ksergy1/wind-turbine-pressure-motors/manual/device_mgr.jpg

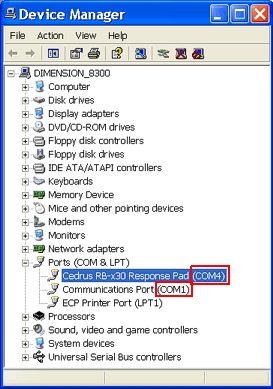
manual/device_mgr.jpg
