ksergy1/wind-turbine-pressure-motors/manual/manual3.jpg

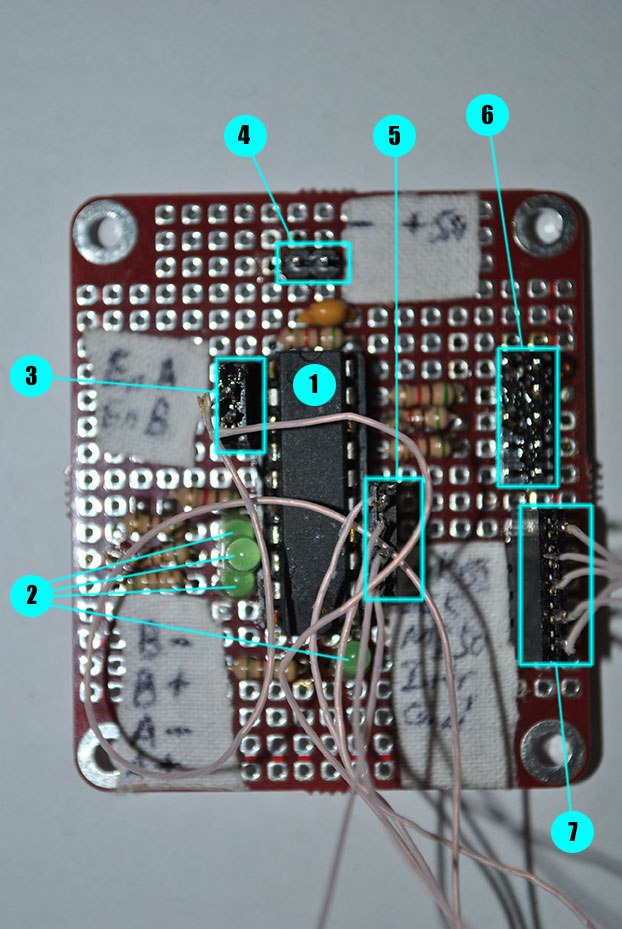
manual/manual3.jpg
