ksergy1/wind-turbine-pressure-motors/(list of files, cad)

Other CAD files:
asm/slave-drive-test/slave-drive-test.obj
asm/slave-spi-test/slave-spi-test.obj
asm/slave-uart/slave-uart.obj
asm/slave.backup/slave.backup.obj
asm/slave/slave.obj
asm/system-loopback-test/system-loopback-test.obj
asm/system-spi-test/system-spi-test.obj
asm/system-test-uart/system-test-uart.obj
asm/system/system.obj
