ksergy1/wind-turbine-pressure-motors/one-drv.pdf

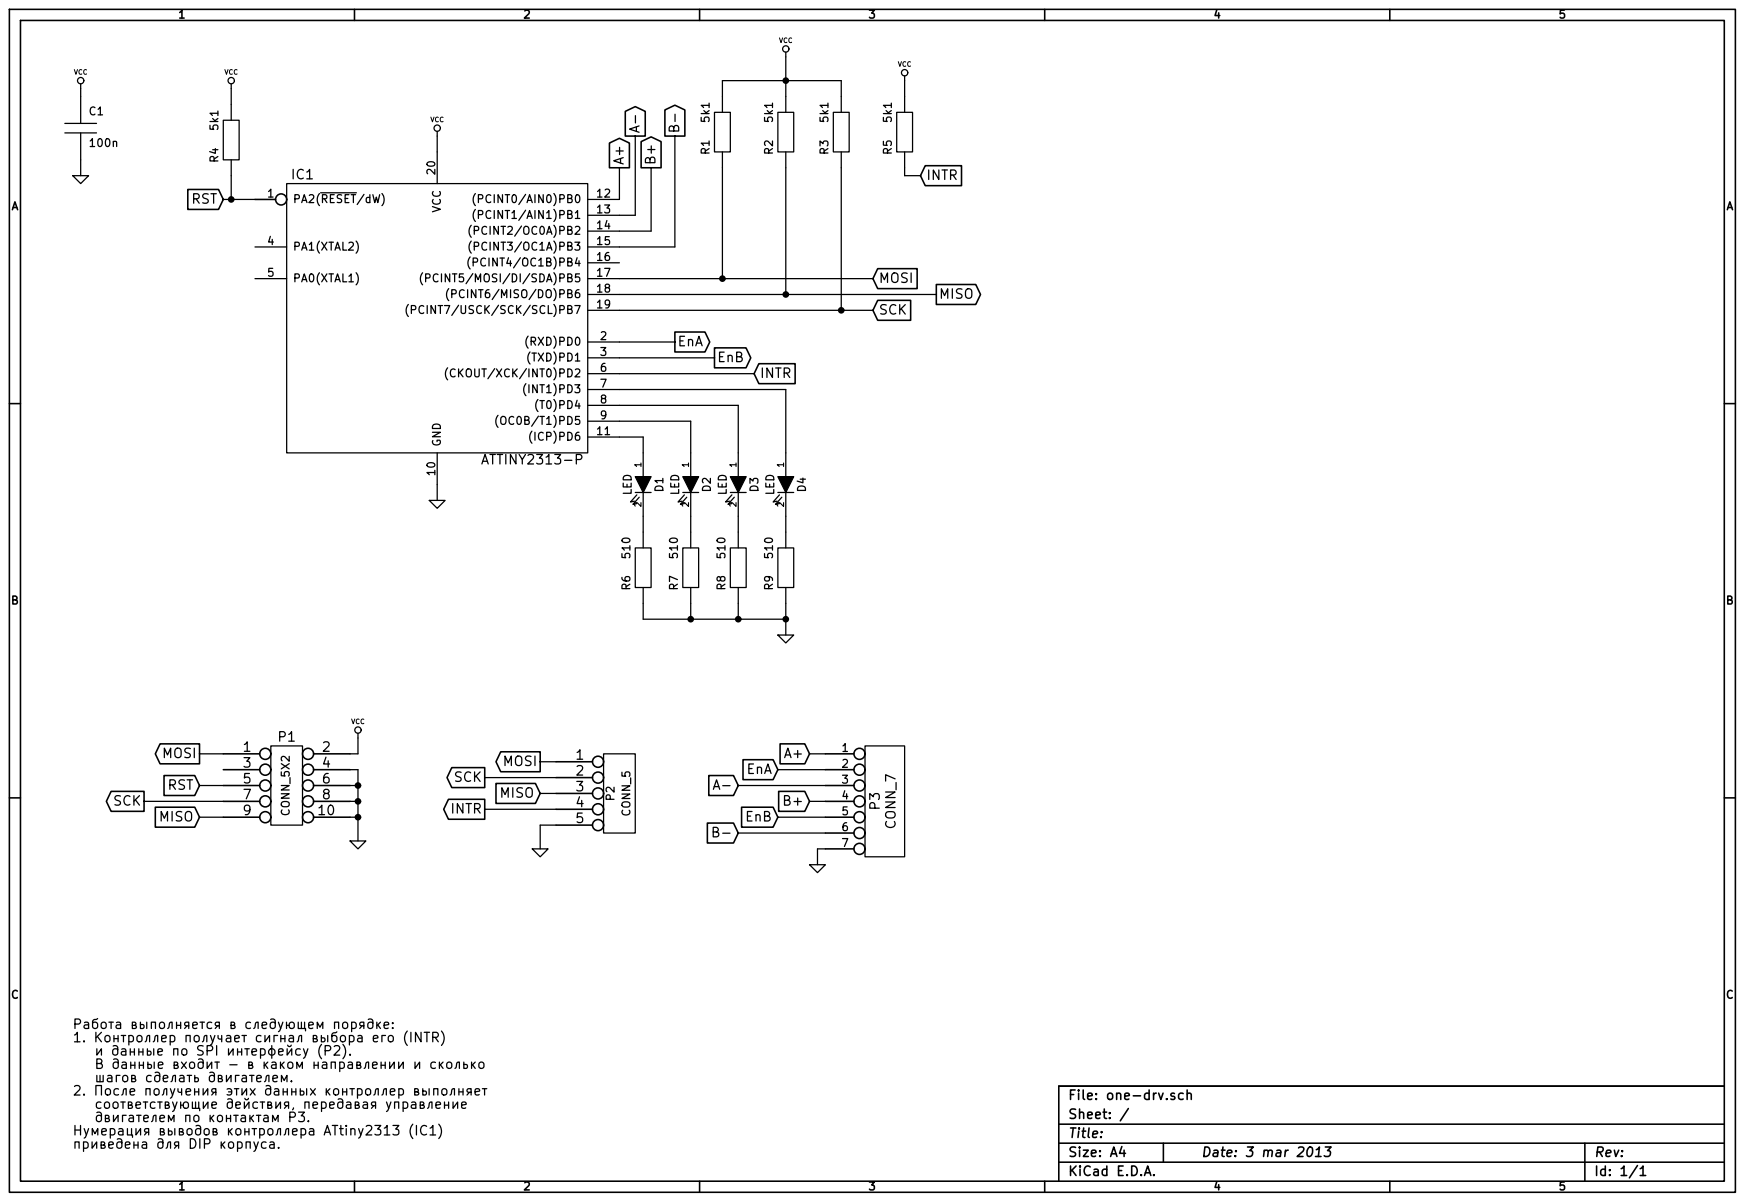
[picture p8: page 1]
