ksergy1/wind-turbine-pressure-motors/system.pdf

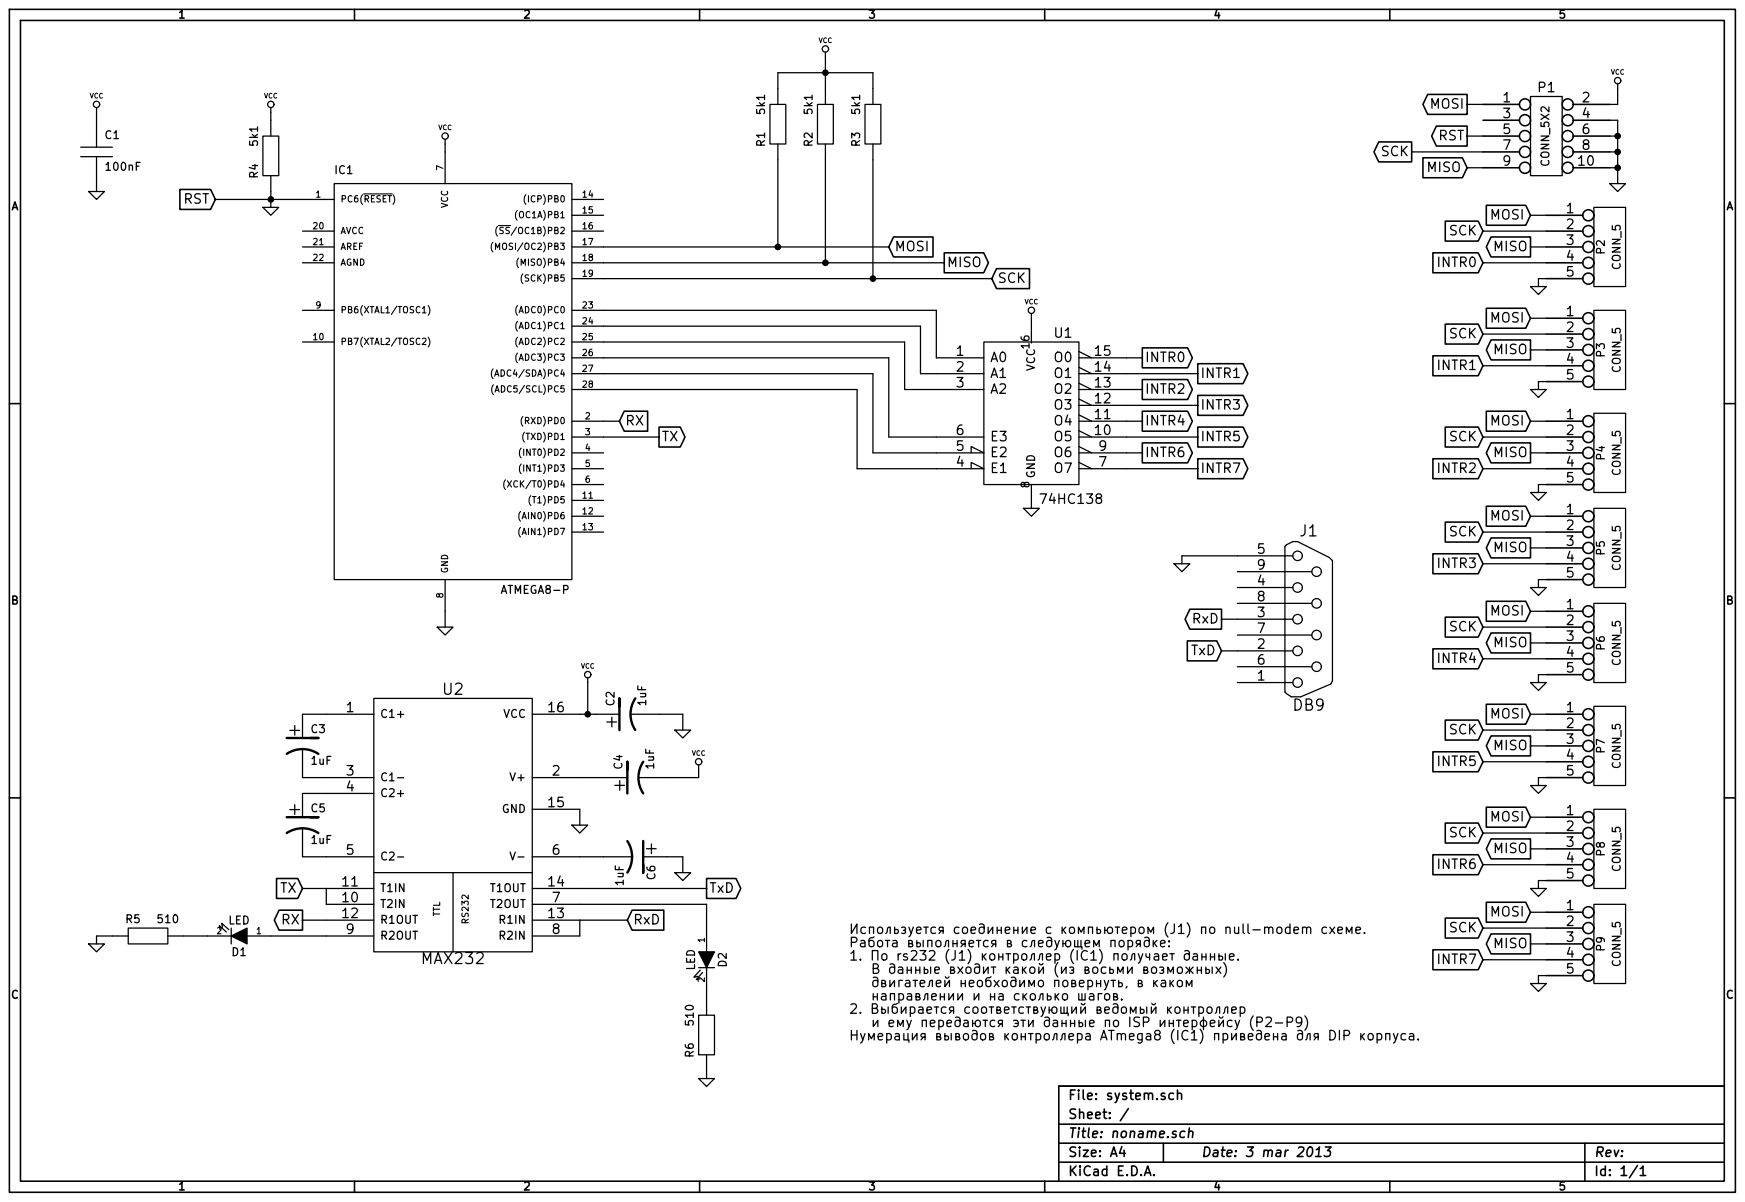
[picture p9: page 1]
