ksergy1/wind-turbine-pressure-motors/one-drv.sch

## KiCad design one-drv.sch (2016-01-23)

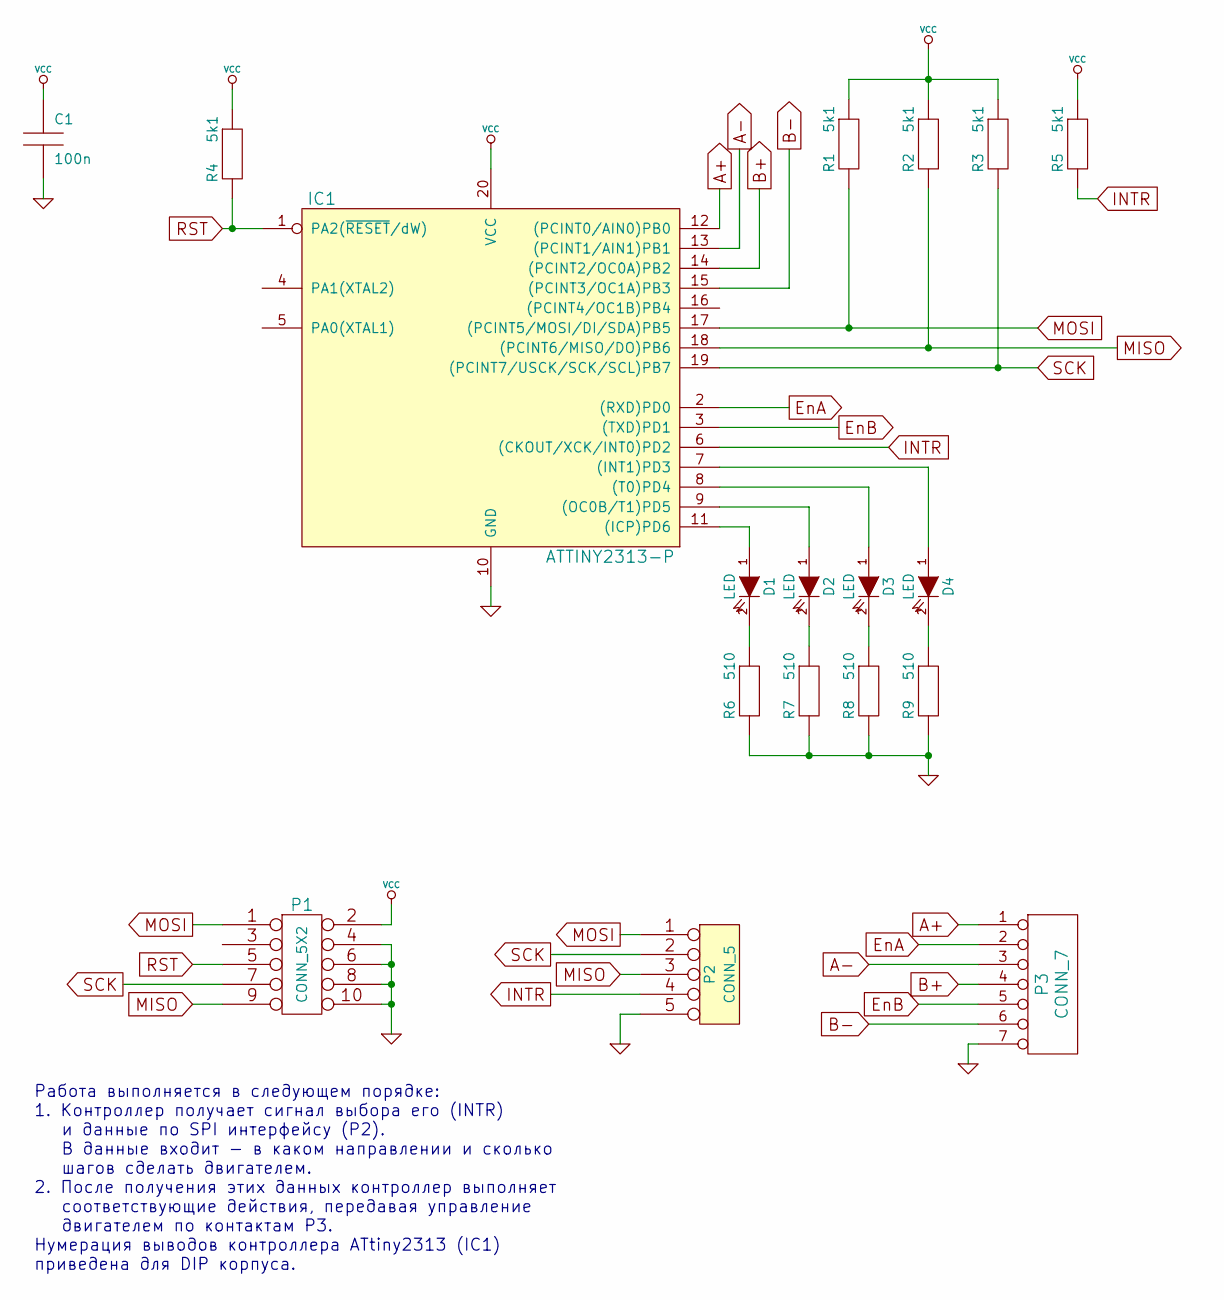
[picture p10: schematic one-drv.sch]

Parts:
C1: 100n
D1, D2, D3, D4: LED
IC1: ATTINY2313-P; DIP20
P1: CONN_5X2
P2: CONN_5
P3: CONN_7
R1, R2, R3, R4, R5: 5k1
R6, R7, R8, R9: 510

Connections:
A+: IC1.12 ((PCINT0/AIN0)PB0), P3.1
A-: IC1.13 ((PCINT1/AIN1)PB1), P3.3
B+: IC1.14 ((PCINT2/OC0A)PB2), P3.4
B-: IC1.15 ((PCINT3/OC1A)PB3), P3.6
EnA: IC1.2 ((RXD)PD0), P3.2
EnB: IC1.3 ((TXD)PD1), P3.5
GND: C1.2, IC1.10 (GND), P1.4, P1.6, P1.8, P1.10, P2.5, P3.7, R6.2, R7.2, R8.2, R9.2
INTR: IC1.6 ((CKOUT/XCK/INT0)PD2), P2.4, R5.2
MISO: IC1.18 ((PCINT6/MISO/DO)PB6), P1.9, P2.3, R2.2
MOSI: IC1.17 ((PCINT5/MOSI/DI/SDA)PB5), P1.1, P2.1, R1.2
unnamed: D1.1 (A), IC1.11 ((ICP)PD6)
unnamed: D1.2 (K), R6.1
unnamed: D2.1 (A), IC1.9 ((OC0B/T1)PD5)
unnamed: D2.2 (K), R7.1
unnamed: D3.1 (A), IC1.8 ((T0)PD4)
unnamed: D3.2 (K), R8.1
unnamed: D4.1 (A), IC1.7 ((INT1)PD3)
unnamed: D4.2 (K), R9.1
RST: IC1.1 (PA2(~RESET~/dW)), P1.5, R4.2
SCK: IC1.19 ((PCINT7/USCK/SCK/SCL)PB7), P1.7, P2.2, R3.2
VCC: C1.1, IC1.20 (VCC), P1.2, R1.1, R2.1, R3.1, R4.1, R5.1

Notes on the sheet:
Работа выполняется в следующем порядке: 1. Контроллер получает сигнал выбора его (INTR) и данные по SPI интерфейсу (P2). В данные входит - в каком направлении и сколько шагов сделать двигателем. 2. После получения этих данных контроллер выполняет соответствующие действия, передавая управление двига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
