ksergy1/wind-turbine-pressure-motors/system.sch

## KiCad design system.sch (2016-01-23)

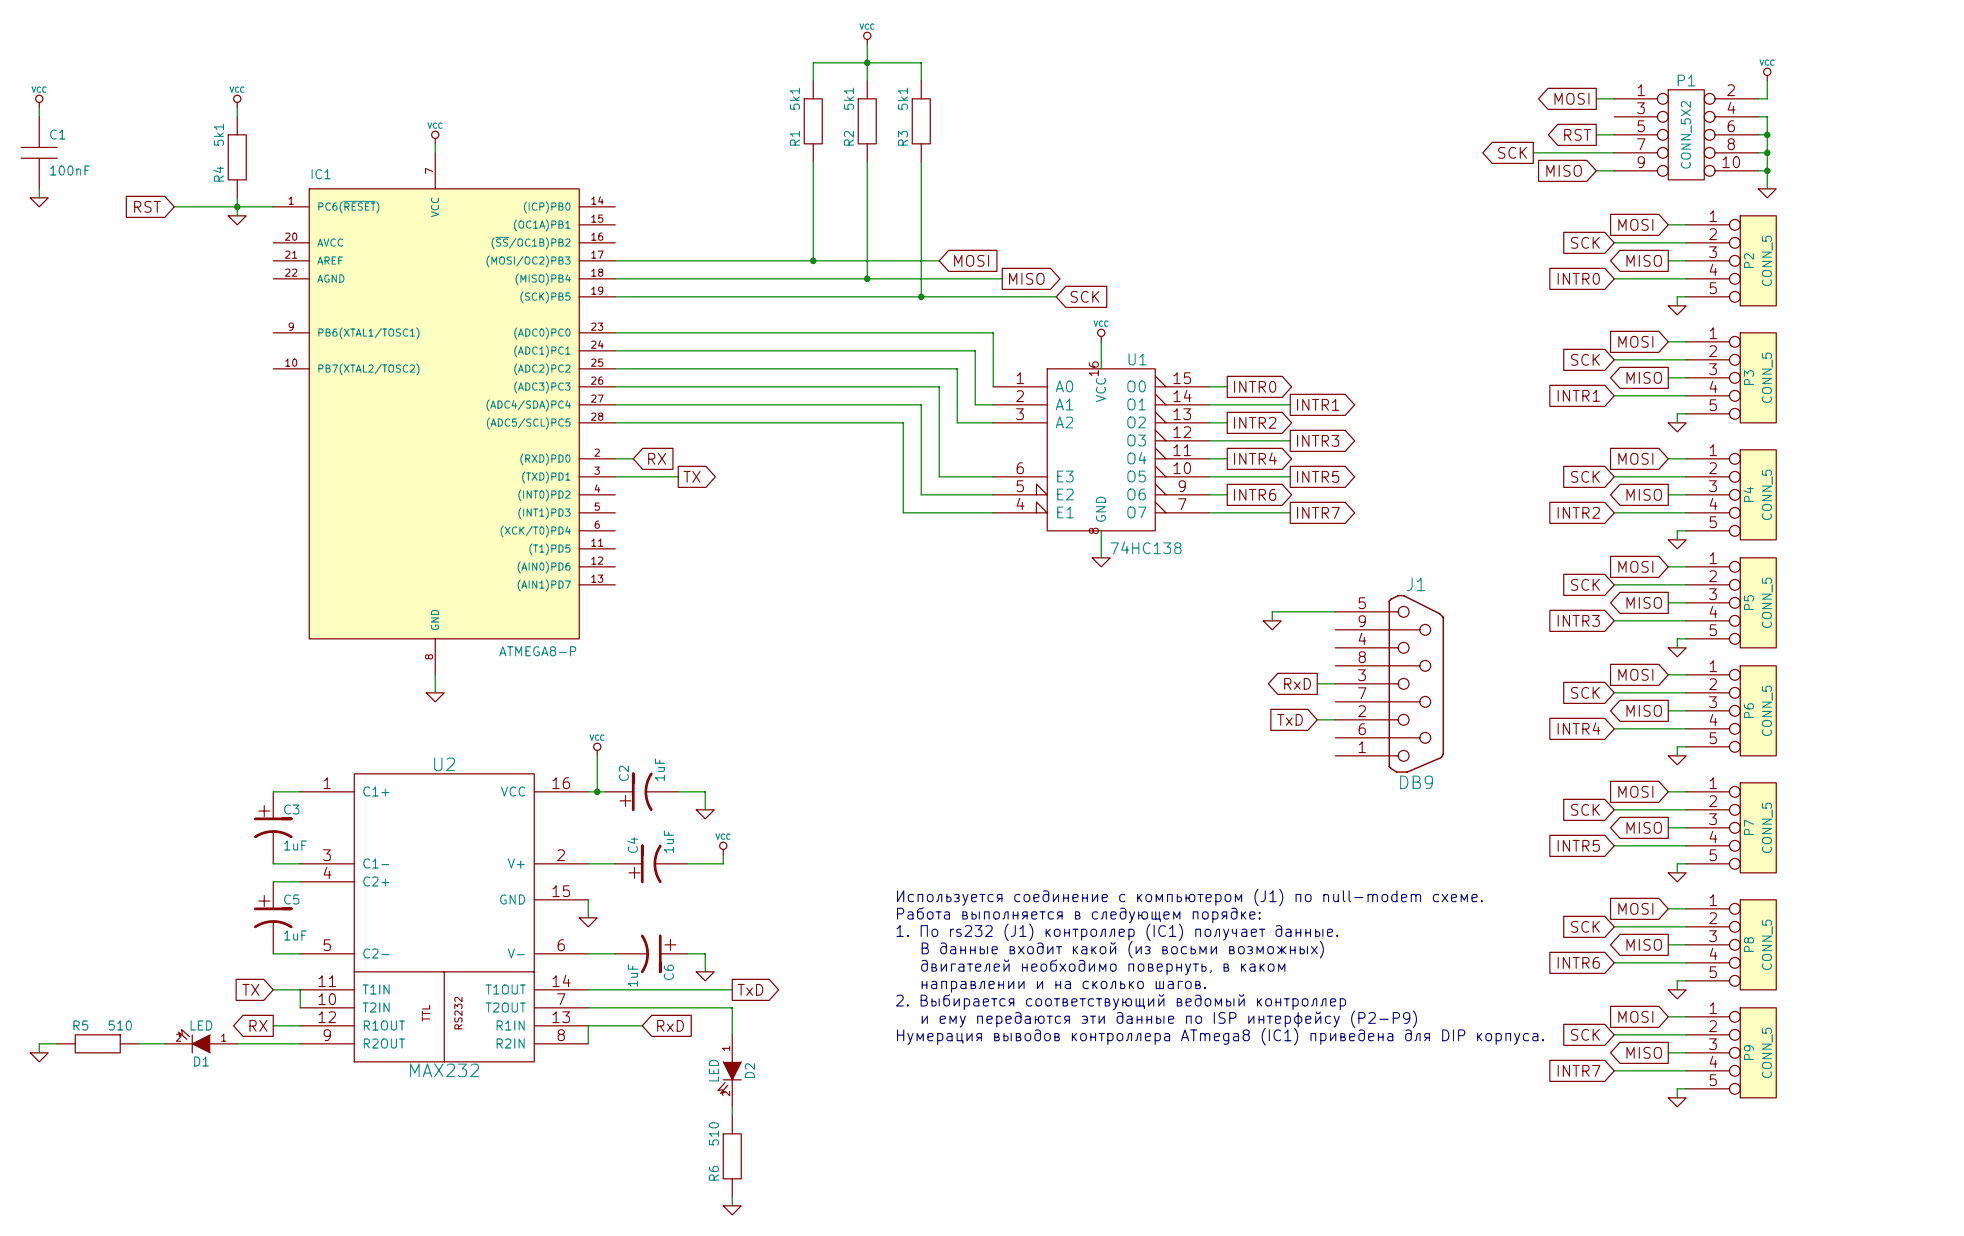
[picture p11: schematic system.sch]

Parts:
C1: 100nF
C2, C3, C4, C5, C6: 1uF
D1, D2: LED
IC1: ATMEGA8-P; DIL28
J1: DB9
P1: CONN_5X2
P2, P3, P4, P5, P6, P7, P8, P9: CONN_5
R1, R2, R3, R4: 5k1
R5, R6: 510
U1: 74HC138
U2: MAX232

Connections:
GND: C1.2, C2.2, C6.1, IC1.1 (PC6(~RESET~)), IC1.8 (GND), J1.5, P1.4, P1.5, P1.6, P1.8, P1.10, P2.5, P3.5, P4.5, P5.5, P6.5, P7.5, P8.5, P9.5, R4.2, R5.2, R6.2, U1.8 (GND), U2.15 (GND)
INTR0: P2.4, U1.15 (O0)
INTR1: P3.4, U1.14 (O1)
INTR2: P4.4, U1.13 (O2)
INTR3: P5.4, U1.12 (O3)
INTR4: P6.4, U1.11 (O4)
INTR5: P7.4, U1.10 (O5)
INTR6: P8.4, U1.9 (O6)
INTR7: P9.4, U1.7 (O7)
MISO: IC1.18 ((MISO)PB4), P1.9, P2.3, P3.3, P4.3, P5.3, P6.3, P7.3, P8.3, P9.3, R2.2
MOSI: IC1.17 ((MOSI/OC2)PB3), P1.1, P2.1, P3.1, P4.1, P5.1, P6.1, P7.1, P8.1, P9.1, R1.2
unnamed: C3.1, U2.1 (C1+)
unnamed: C3.2, U2.3 (C1-)
unnamed: C4.1, U2.2 (V+)
unnamed: C5.1, U2.4 (C2+)
unnamed: C5.2, U2.5 (C2-)
unnamed: C6.2, U2.6 (V-)
unnamed: D1.1 (A), U2.9 (R2OUT)
unnamed: D1.2 (K), R5.1
unnamed: D2.1 (A), U2.7 (T2OUT)
unnamed: D2.2 (K), R6.1
unnamed: IC1.23 ((ADC0)PC0), U1.1 (A0)
unnamed: IC1.24 ((ADC1)PC1), U1.2 (A1)
unnamed: IC1.25 ((ADC2)PC2), U1.3 (A2)
unnamed: IC1.26 ((ADC3)PC3), U1.6 (E3)
unnamed: IC1.27 ((ADC4/SDA)PC4), U1.5 (E2)
unnamed: IC1.28 ((ADC5/SCL)PC5), U1.4 (E1)
RX: IC1.2 ((RXD)PD0), U2.12 (R1OUT)
RxD: J1.3, U2.8 (R2IN), U2.13 (R1IN)
SCK: IC1.19 ((SCK)PB5), P1.7, P2.2, P3.2, P4.2, P5.2, P6.2, P7.2, P8.2, P9.2, R3.2
TX: IC1.3 ((TXD)PD1), U2.10 (T2IN), U2.11 (T1IN)
TxD: J1.2, U2.14 (T1OUT)
VCC: C1.1, C2.1, C4.2, IC1.7 (VCC), P1.2, R1.1, R2.1, R3.1, R4.1, U1.16 (VCC), U2.16 (VCC)

Notes on the sheet:
Используется соединение с компьютером (J1) по null-modem схеме. Работа выполняется в следующем порядке: 1. По rs232 (J1) контроллер (IC1) получает данные. В данные входит какой (из восьми возможных) двигателей необходимо повернуть, в каком направлении и на сколько шагов. 2. Выбирается соответствующ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
