ksergy1/wind-turbine-pressure-motors/c/Win2/Serial_forms/Resource.h

//{{NO_DEPENDENCIES}}
// Microsoft Visual C++ generated include file.
// Used by Serial_forms.rc
//

#define IDS_APP_TITLE			103

#define IDR_MAINFRAME			128
#define IDD_SERIAL_FORMS_DIALOG	102
#define IDD_ABOUTBOX			103
#define IDM_ABOUT				104
#define IDM_EXIT				105
#define IDI_SERIAL_FORMS			107
#define IDI_SMALL				108
#define IDC_SERIAL_FORMS			109
#define IDC_MYICON				2
#ifndef IDC_STATIC
#define IDC_STATIC				-1
#endif
#define IDC_CONNECT_BUTTON 121
#define IDC_SEND_BUTTON 122
#define IDC_DISCONNECT_BUTTON 123
#define IDC_PORTNAME_EDIT 124
#define IDC_NDRV_EDIT 125
#define IDC_NSTEP_EDIT 126
#define IDC_DIR_EDIT 127
#define IDC_NDRV_LABEL 128
#define IDC_NSTEP_LABEL 129
#define IDC_DIR_LABEL 130
#define IDC_PORTNAME_LABEL 130
// Next default values for new objects
// 
#ifdef APSTUDIO_INVOKED
#ifndef APSTUDIO_READONLY_SYMBOLS

#define _APS_NO_MFC					130
#define _APS_NEXT_RESOURCE_VALUE	129
#define _APS_NEXT_COMMAND_VALUE		32771
#define _APS_NEXT_CONTROL_VALUE		1000
#define _APS_NEXT_SYMED_VALUE		110
#endif
#endif
